syprent/Project-ESP32-Blynk-RGB-LED-strip/(commit log)

2024-01-04 faltas de ortografia
2024-01-17 actualziacion mosfets
2024-01-17 final stage
